chickadee-tech/metro_m7_1011_trace/Metro M7 RT1011 SD rev A.kicad_pcb

## KiCad design Metro M7 RT1011 SD rev A.kicad_pcb (2023-08-18)

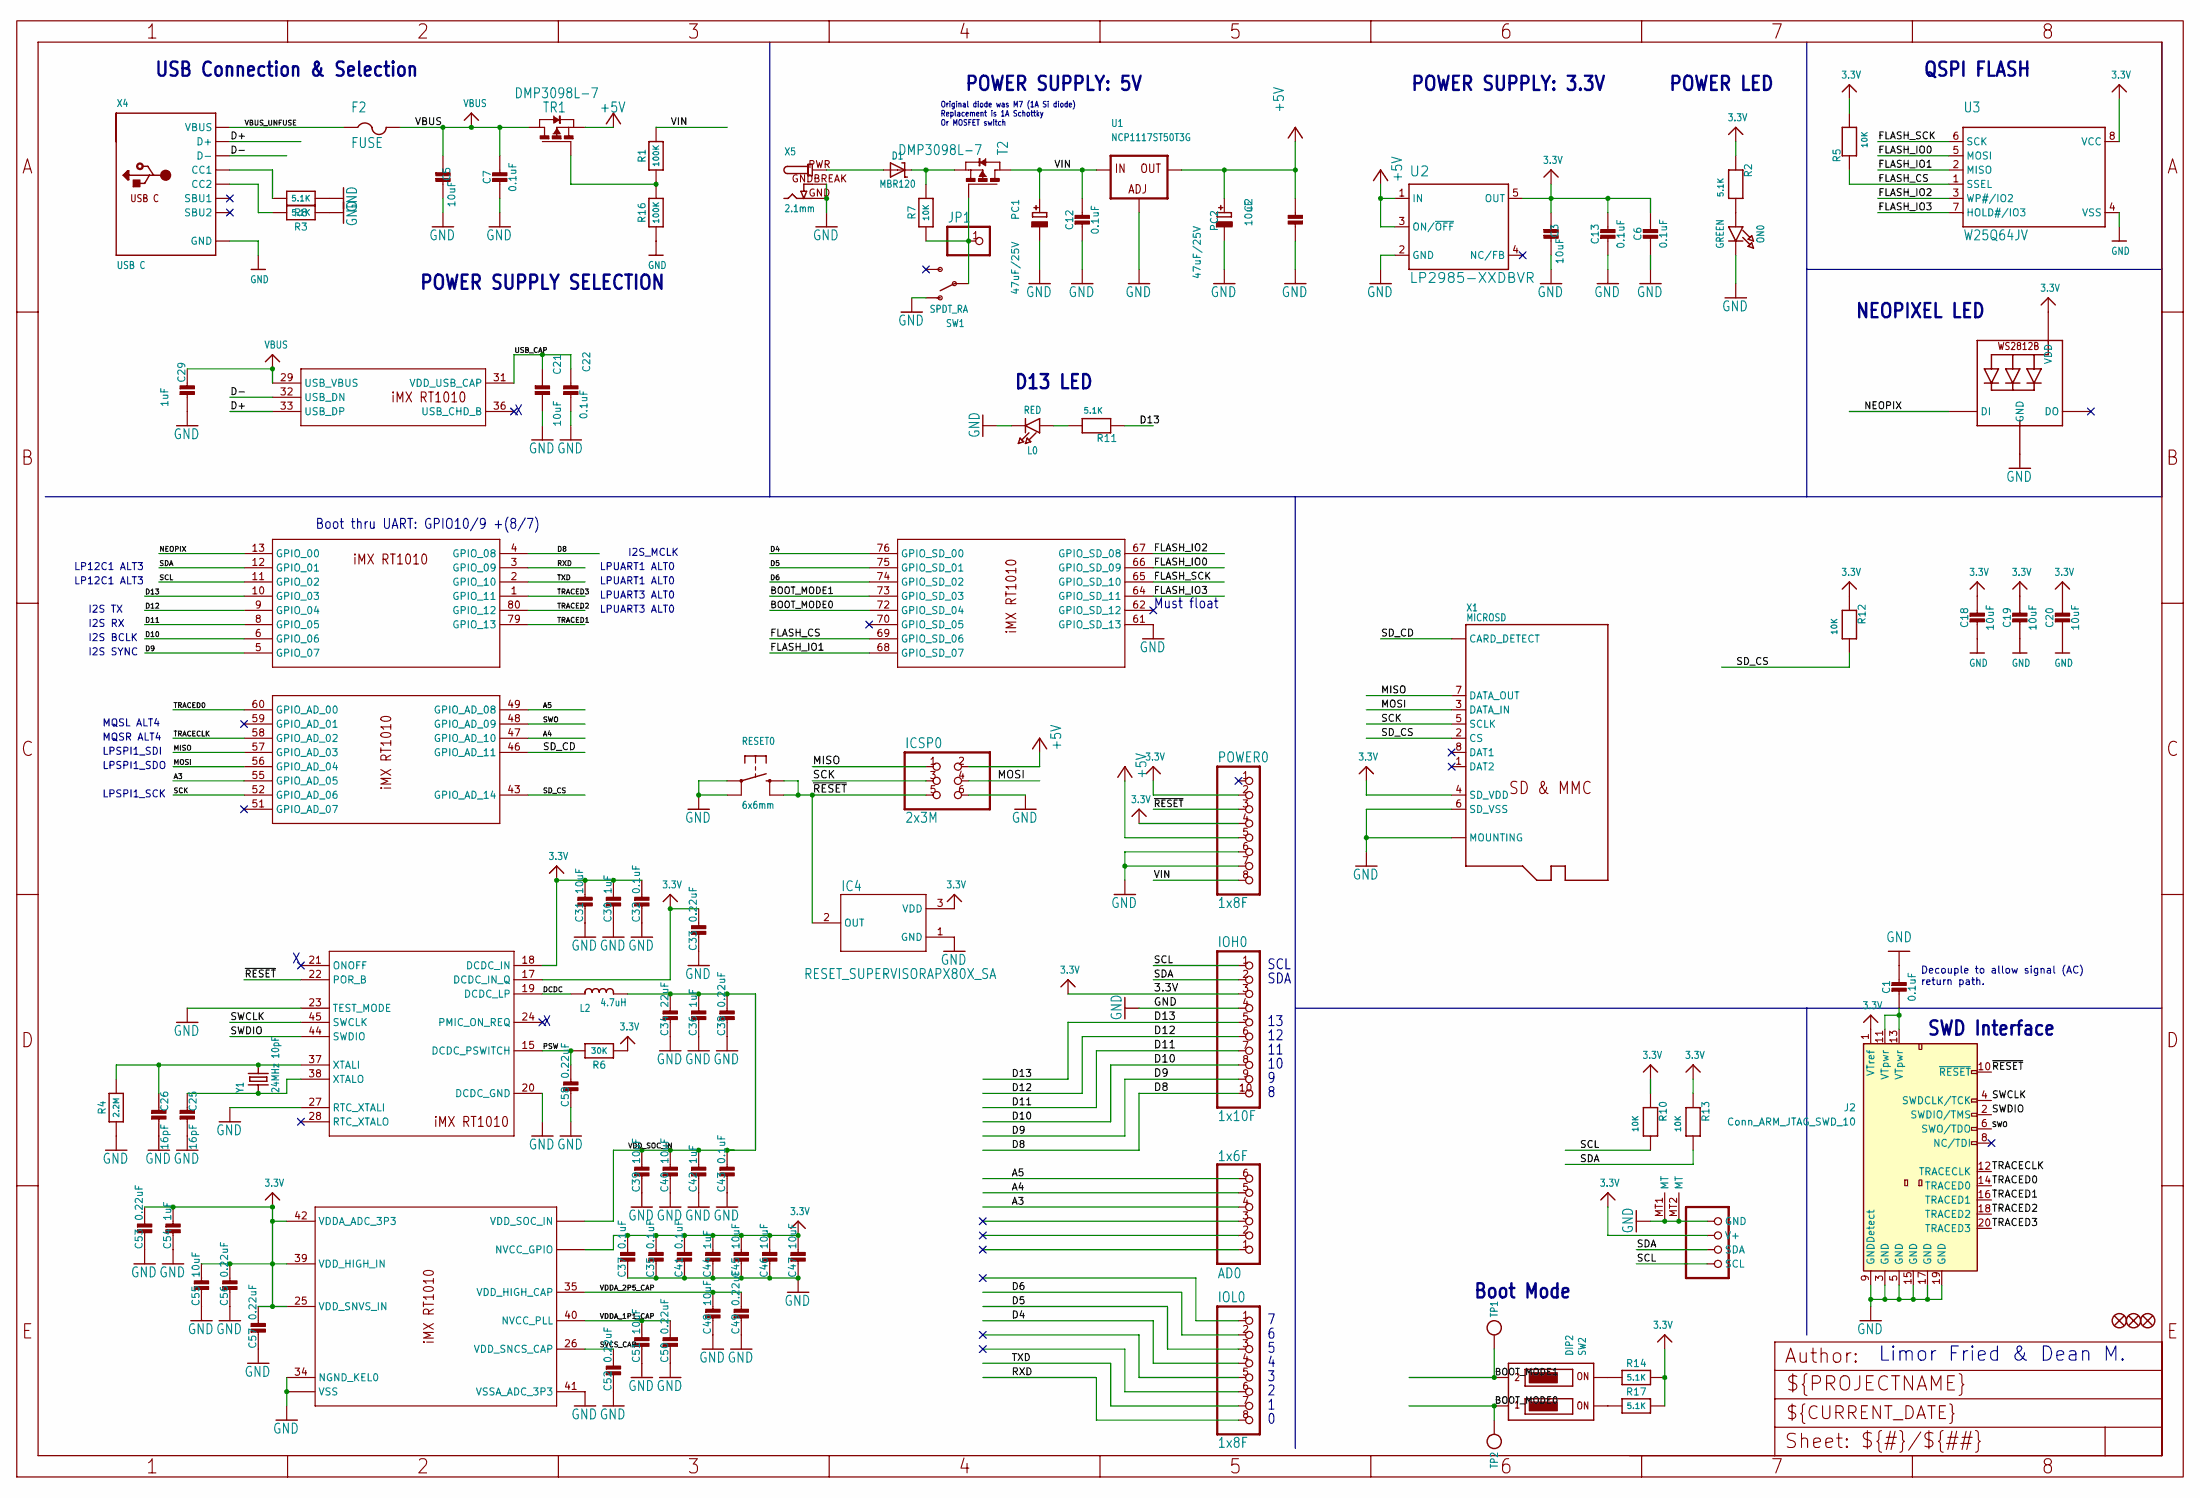
[picture p1: schematic Metro M7 RT1011 SD rev A.kicad_sch]

Parts:
AD0: 1x6F; 1X06_OVALWAVE
C1, C6, C7, C12, C13, C22, C32, C35, C37, C41, C43: 0.1uF; 0603-NO
C2, C3, C5, C18, C19, C20, C21, C31, C39, C40, C45, C46, C47, C48, C51, C55: 10uF; 0805-NO
C25, C26: 16pF; 0603-NO
C29, C30, C36, C42, C44, C54: 1uF; 0603-NO
C33, C38, C49, C50, C52, C53, C56, C57, C58: 0.22uF; 0603-NO
C34: 22uF; 0805-NO
CONN1: STEMMA_I2C_QT; JST_SH4
D1: MBR120; SOD-123
F2: FUSE; R1206
FD1, FD2, FD3: FIDUCIAL_1MM
IC2: IMX_RT1010; QFP50P1400X1400X160-80N
IC4: RESET_SUPERVISORAPX80X_SA; SOT23-WIDE
ICSP0: 2x3M; 2X03_ROUND_70MIL
IOH0: 1x10F; 1X10_OVALWAVE
IOL0: 1x8F; 1X08_OVALWAVE
J2: Conn_ARM_JTAG_SWD_10; PinHeader_2x10_P1.27mm_Vertical_SMD
JP1: HEADER-1X1ROUND; 1X01_ROUND
L0: RED; CHIPLED_0603_NOOUTLINE
L2: 4.7uH; INDUCTOR_1007
LED1: WS2812B_3535FULL; LED3535_FULLPADS
ON0: GREEN; CHIPLED_0603_NOOUTLINE
PC1, PC2: 47uF/25V; PANASONIC_D
POWER0: 1x8F; 1X08_OVALWAVE
R1, R16: 100K; 0603-NO
R2, R3, R8, R11, R14, R17: 5.1K; 0603-NO
R4: 2.2M; 0603-NO
R5, R7, R10, R12, R13: 10K; 0603-NO
R6: 30K; 0603-NO
RESET0: 6x6mm; 6MMX6MM_TACTILE_SMT
SW1: SPDT_RA; SPDT_SMT_SSSS811101
SW2: DIP2; DIPSWITCH_2PIN
T2: DMP3098L-7; SOT-23
TP1, TP2: TESTPOINTROUND1.5MM; TESTPOINT_ROUND_1.5MM
TR1: DMP3098L-7; SOT-23
U1: NCP1117ST50T3G; SOT223-R
U2: LP2985-XXDBVR; SOT23-DBV
U3: W25Q64JV; SOIC8_208MIL
X1: MICROSD
X4: USB C; USB_C_CUSB31-CFM2AX-01-X
X5: 2.1mm; DCJACK_2MM_PTH
Y1: 24MHz 10pF; CRYSTAL_2.5X2

Connections:
3.3V: C3.2, C6.2, C13.1, C18.1, C19.1, C20.1, C30.1, C31.1, C32.1, C33.1, C35.1, C37.1, C41.1, C44.1, C45.1, C46.1, C47.1, C53.1, C54.1, C55.1, C56.1, C57.1, CONN1.2 (V+), IC2.7 (NVCC_GPIO), IC2.17 (DCDC_IN_Q), IC2.18 (DCDC_IN), IC2.25 (VDD_SNVS_IN), IC2.39 (VDD_HIGH_IN), IC2.42 (VDDA_ADC_3P3), IC2.50 (NVCC_GPIO), IC2.63 (NVCC_GPIO), IC2.71 (NVCC_GPIO), IC4.3 (VDD), IOH0.3, J2.1 (VTref), LED1.2 (VDD), POWER0.2, POWER0.4, R2.1, R5.2, R6.1, R10.1, R12.1, R13.1, R14.2, R17.2, U2.5 (OUT), U3.8 (VCC), X1.4 (SD_VDD)
+5V: C2.2, ICSP0.2, PC2.+, POWER0.5, TR1.2 (S), U1.2 (OUT), U1.4 (OUT), U2.1 (IN), U2.3 (ON/~OFF)
/A3: AD0.4, IC2.55 (GPIO_AD_05)
/A4: AD0.5, IC2.47 (GPIO_AD_10)
/A5: AD0.6, IC2.49 (GPIO_AD_08)
/BOOT_MODE0: IC2.72 (GPIO_SD_04), SW2.1OFF, TP2.P$1
/BOOT_MODE1: IC2.73 (GPIO_SD_03), SW2.2OFF, TP1.P$1
/D4: IC2.76 (GPIO_SD_00), IOL0.4
/D5: IC2.75 (GPIO_SD_01), IOL0.3
/D6: IC2.74 (GPIO_SD_02), IOL0.2
/D8: IC2.4 (GPIO_08), IOH0.10
/D9: IC2.5 (GPIO_07), IOH0.9
/D10: IC2.6 (GPIO_06), IOH0.8
/D11: IC2.8 (GPIO_05), IOH0.7
/D12: IC2.9 (GPIO_04), IOH0.6
/D13: IC2.10 (GPIO_03), IOH0.5, R11.1
/D+: IC2.33 (USB_DP), X4.A6 (D+), X4.B6 (D+)
/D-: IC2.32 (USB_DN), X4.A7 (D-), X4.B7 (D-)
/DCDC: IC2.19 (DCDC_LP), L2.P$1 (1)
/FLASH_CS: IC2.69 (GPIO_SD_06), R5.1, U3.1 (SSEL)
/FLASH_IO0: IC2.66 (GPIO_SD_09), U3.5 (MOSI)
/FLASH_IO1: IC2.68 (GPIO_SD_07), U3.2 (MISO)
/FLASH_IO2: IC2.67 (GPIO_SD_08), U3.3 (WP#/IO2)
/FLASH_IO3: IC2.64 (GPIO_SD_11), U3.7 (HOLD#/IO3)
/FLASH_SCK: IC2.65 (GPIO_SD_10), U3.6 (SCK)
/MISO: IC2.57 (GPIO_AD_03), ICSP0.1, X1.7 (DATA_OUT)
/MOSI: IC2.56 (GPIO_AD_04), ICSP0.4, X1.3 (DATA_IN)
/NEOPIX: IC2.13 (GPIO_00), LED1.1 (DI)
/PSW: C58.1, IC2.15 (DCDC_PSWITCH), R6.2
/RXD: IC2.3 (GPIO_09), IOL0.8
/SCK: IC2.52 (GPIO_AD_06), ICSP0.3, X1.5 (SCLK)
/SCL: CONN1.4 (SCL), IC2.11 (GPIO_02), IOH0.1, R10.2
/SDA: CONN1.3 (SDA), IC2.12 (GPIO_01), IOH0.2, R13.2
/SD_CD: IC2.46 (GPIO_AD_11), X1.CD1 (CARD_DETECT), X1.CD2 (CARD_DETECT)
/SD_CS: IC2.43 (GPIO_AD_14), R12.2, X1.2 (CS)
/SVCS_CAP: C52.1, IC2.26 (VDD_SNCS_CAP)
/SWCLK: IC2.45 (SWCLK), J2.4 (SWDCLK/TCK)
/SWDIO: IC2.44 (SWDIO), J2.2 (SWDIO/TMS)
/SWO: IC2.48 (GPIO_AD_09), J2.6 (SWO/TDO)
/TRACECLK: IC2.58 (GPIO_AD_02), J2.12 (TRACECLK)
/TRACED0: IC2.60 (GPIO_AD_00), J2.14 (TRACED0)
/TRACED1: IC2.79 (GPIO_13), J2.16 (TRACED1)
/TRACED2: IC2.80 (GPIO_12), J2.18 (TRACED2)
/TRACED3: IC2.1 (GPIO_11), J2.20 (TRACED3)
/TXD: IC2.2 (GPIO_10), IOL0.7
/USB_CAP: C21.2, C22.1, IC2.31 (VDD_USB_CAP)
/VBUS_UNFUSE: F2.1, X4.A4B9 (VBUS), X4.B4A9 (VBUS)
/VDDA_1P1_CAP: C50.1, C51.1, IC2.40 (NVCC_PLL)
/VDDA_2P5_CAP: C48.1, C49.1, IC2.35 (VDD_HIGH_CAP)
/VDD_SOC_IN: C34.1, C36.1, C38.1, C39.1, C40.1, C42.1, C43.1, IC2.14 (VDD_SOC_IN), IC2.53 (VDD_SOC_IN), IC2.77 (VDD_SOC_IN), L2.P$2 (2)
/VIN: C12.1, PC1.+, POWER0.8, R1.2, T2.1 (D), U1.3 (IN)
/~RESET: IC2.22 (POR_B), IC4.2 (OUT), ICSP0.5, J2.10 (~RESET), POWER0.3, RESET0.B (S), RESET0.B' (S1)
GND: C1.1, C2.1, C3.1, C5.1, C6.1, C7.2, C12.2, C13.2, C18.2, C19.2, C20.2, C21.1, C22.2, C25.2, C26.2, C29.2, C30.2, C31.2, C32.2, C33.2, C34.2, C35.2, C36.2, C37.2, C38.2, C39.2, C40.2, C41.2, C42.2, C43.2, C44.2, C45.2, C46.2, C47.2, C48.2, C49.2, C50.2, C51.2, C52.2, C53.2, C54.2, C55.2, C56.2, C57.2, C58.2, CONN1.1 (GND), CONN1.MT1 (MT), CONN1.MT2 (MT), IC2.16 (VSS), IC2.20 (DCDC_GND), IC2.23 (TEST_MODE), IC2.27 (RTC_XTALI), IC2.30 (VSS), IC2.34 (NGND_KEL0), IC2.41 (VSSA_ADC_3P3), IC2.54 (VSS), IC2.61 (GPIO_SD_13), IC2.78 (VSS), IC4.1 (GND), ICSP0.6, IOH0.4, J2.3 (GND), J2.5 (GND), J2.9 (GNDDetect), J2.15 (GND), J2.17 (GND), J2.19 (GND), L0.C, LED1.4 (GND), ON0.C, PC1.-, PC2.-, POWER0.6, POWER0.7, R3.1, R4.1, R8.1, R16.1, RESET0.A, RESET0.A' (P1), SW1.A (O), U1.1 (ADJ), U2.2 (GND), U3.4 (VSS), X1.6 (SD_VSS), X1.MT1 (MOUNTING), X1.MT2 (MOUNTING), X4.A1B12 (GND), X4.B1A12 (GND), X5.GND, X5.GNDBREAK
unnamed: C1.2, J2.11 (VTpwr), J2.13 (VTpwr)
unnamed: D1.A, X5.PWR
unnamed: C26.1, IC2.37 (XTALI), R4.2, Y1.3 (2)
unnamed: C25.1, IC2.38 (XTALO), Y1.1
unnamed: L0.A, R11.2
unnamed: ON0.A, R2.2
unnamed: R14.1, SW2.2ON
unnamed: R17.1, SW2.1ON
unnamed: JP1.1, R7.1, SW1.B, T2.3 (G)
unnamed: D1.C, R7.2, T2.2 (S)
unnamed: R1.1, R16.2, TR1.3 (G)
unnamed: R8.2, X4.A5 (CC1)
unnamed: R3.2, X4.B5 (CC2)
VBUS: C5.2, C7.1, C29.1, F2.2, IC2.29 (USB_VBUS), TR1.1 (D)

Notes on the sheet:
LPUART1 ALT0
I2S_MCLK
Must float
POWER SUPPLY SELECTION
LPUART3 ALT0
LPSPI1_SDI
LPSPI1_SDO
Decouple to allow signal (AC) return path.
USB Connection & Selection
Original diode was M7 (1A Si diode) Replacement is 1A Schottky Or MOSFET switch
Boot Mode
I2S SYNC
LP12C1 ALT3
SCL
I2S BCLK
QSPI FLASH
I2S RX
D13 LED
MQSL ALT4
MQSR ALT4
Boot thru UART: GPIO10/9 +(8/7)
I2S TX
SWD Interface
POWER LED
NEOPIXEL LED
POWER SUPPLY: 5V
Limor Fried & Dean M.
LPSPI1_SCK
POWER SUPPLY: 3.3V
SDA

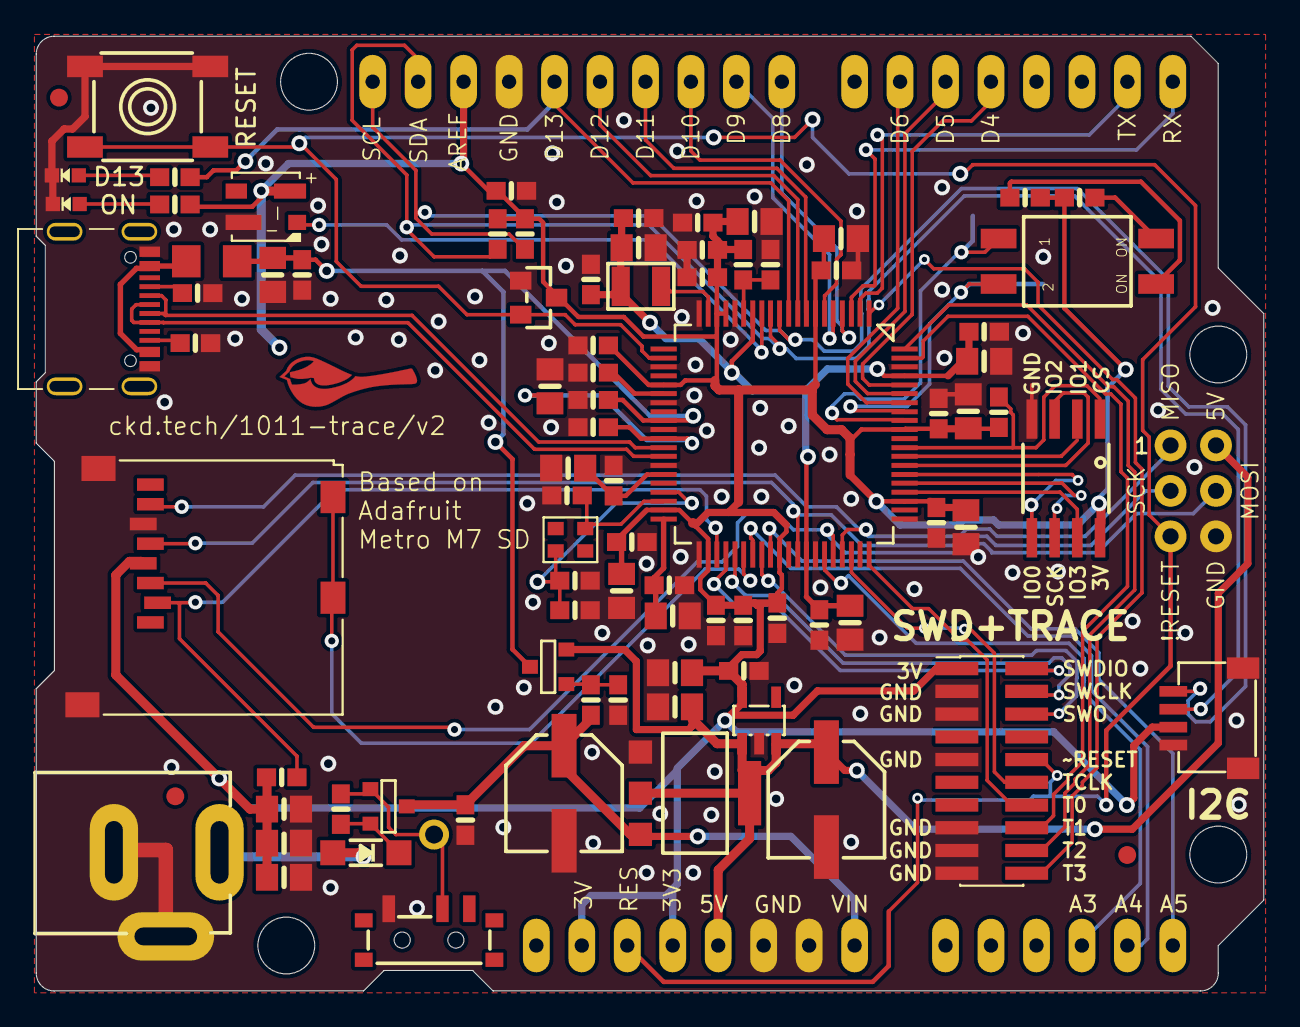
[picture p2: board Metro M7 RT1011 SD rev A.kicad_pcb from above]

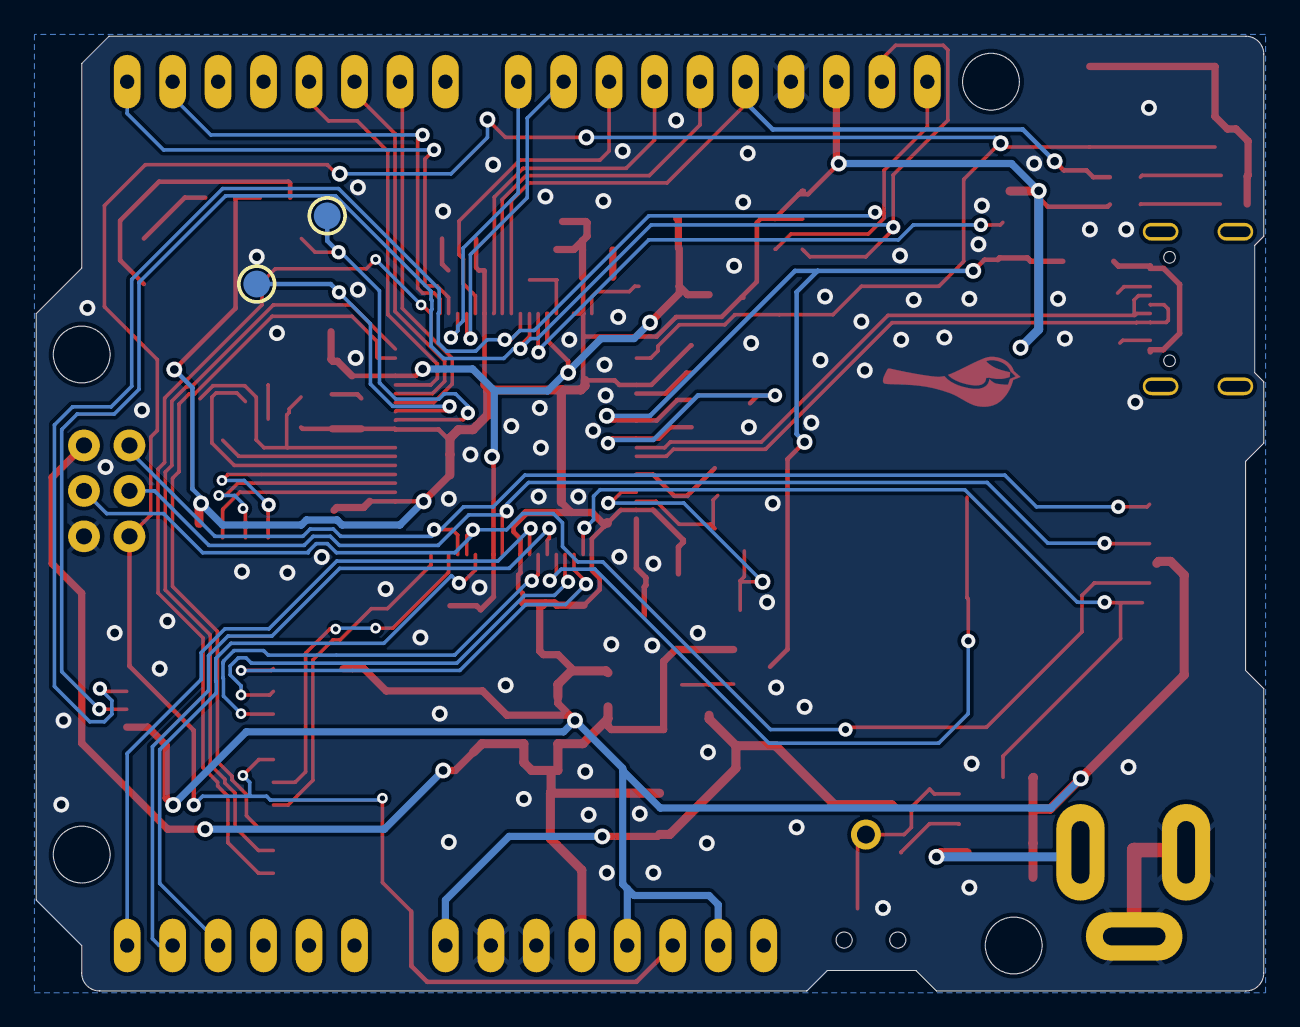
[picture p3: board Metro M7 RT1011 SD rev A.kicad_pcb from below]

Board: 2 copper layers, 68.6 x 53.3 mm, 100 parts (3 on the bottom side), 66 nets.

Other parts of the board:
@HOLE0, @HOLE1, @HOLE2, @HOLE3: (no value)
U$12: M7_RT1011SD_TOP
U$19: M7_RT1011SD_BOT
